AbdullahAlNafisah/fpga-acoustic-localization/docs/figures/after LPF.PNG

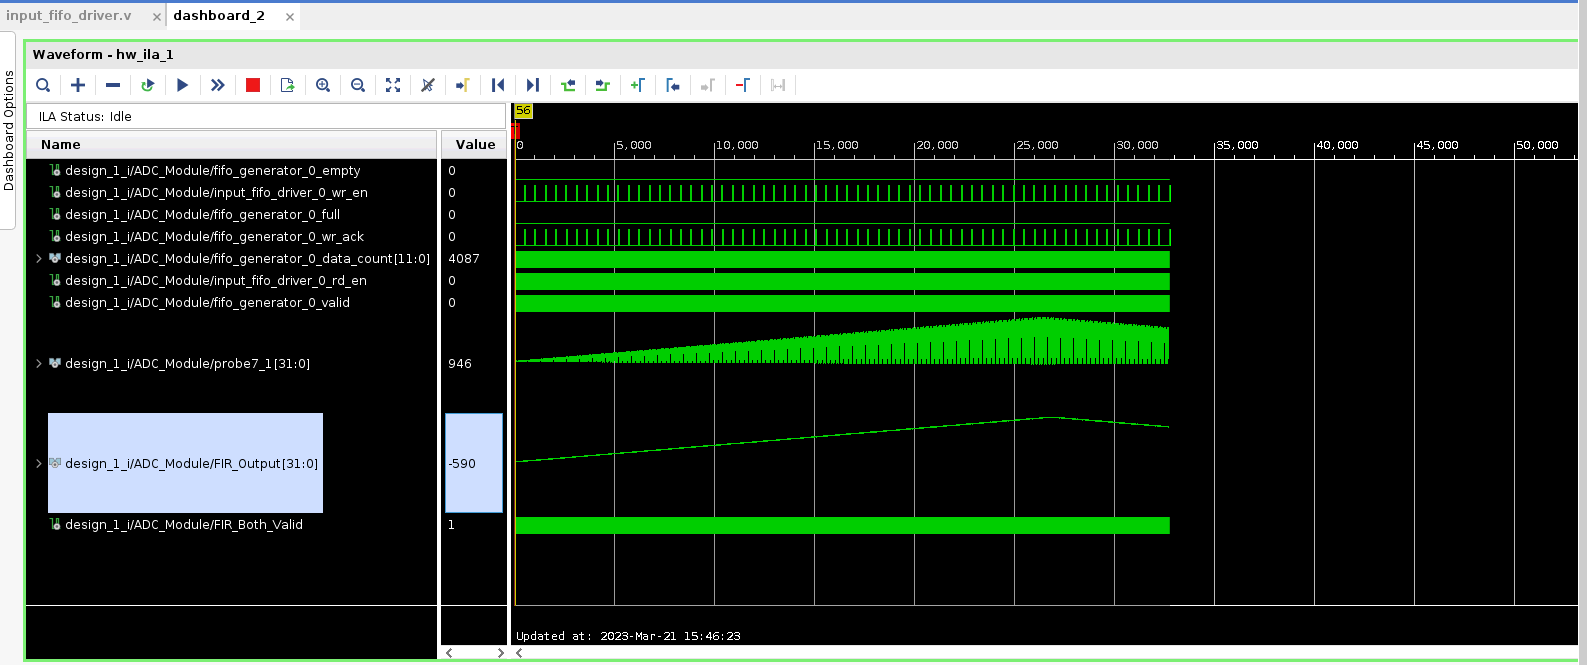
docs/figures/after LPF.PNG
