AbdullahAlNafisah/fpga-acoustic-localization/docs/figures/avgDist.png

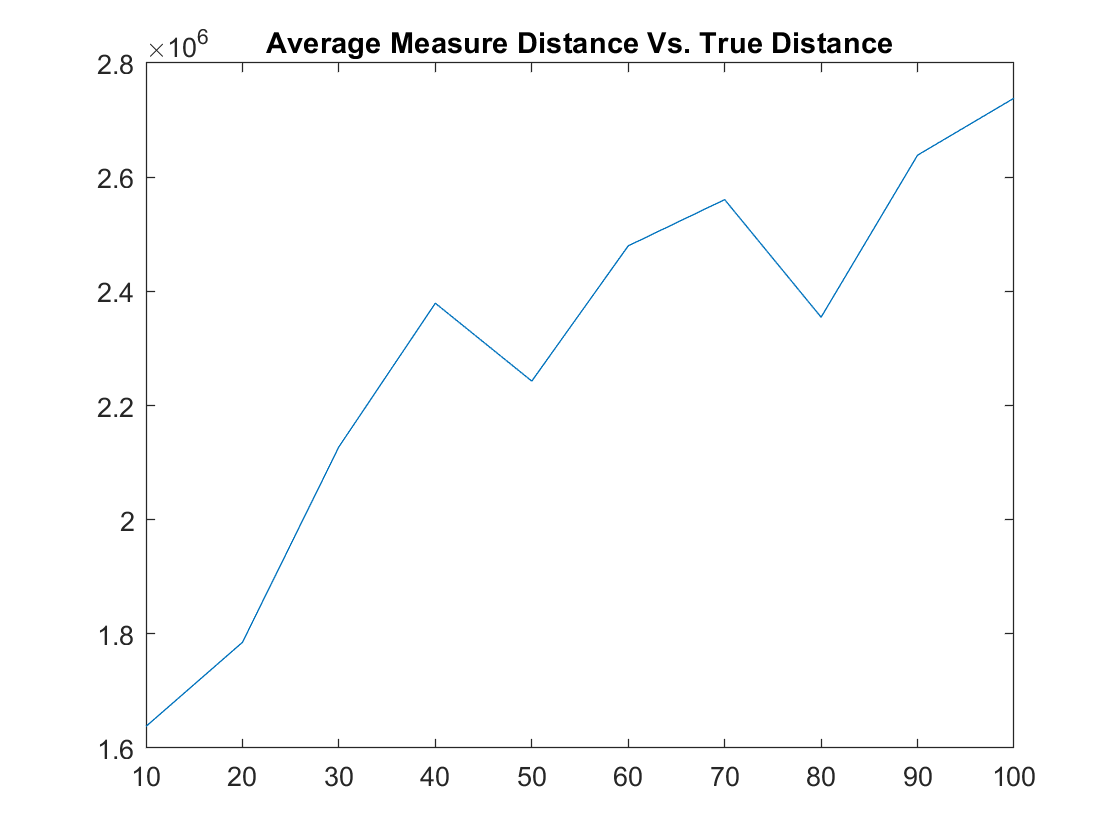
docs/figures/avgDist.png
