AbdullahAlNafisah/fpga-acoustic-localization/docs/figures/clock_drift_lin.jpg

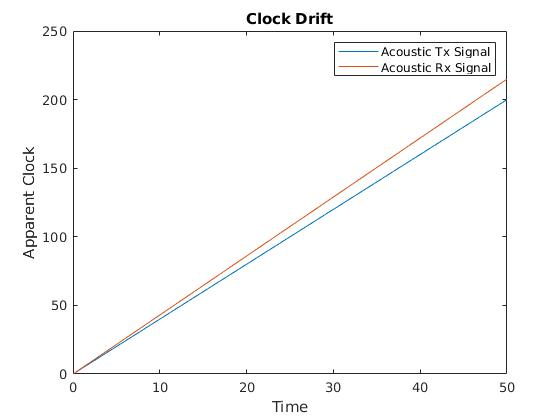
docs/figures/clock_drift_lin.jpg
