AbdullahAlNafisah/fpga-acoustic-localization/docs/figures/clock_drift_saw.jpg

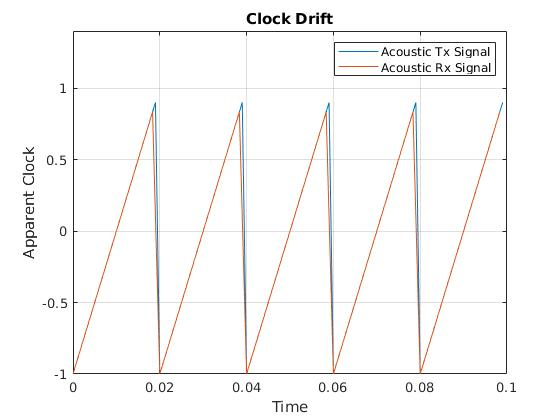
docs/figures/clock_drift_saw.jpg
