AbdullahAlNafisah/fpga-acoustic-localization/docs/figures/realAfterMult.png

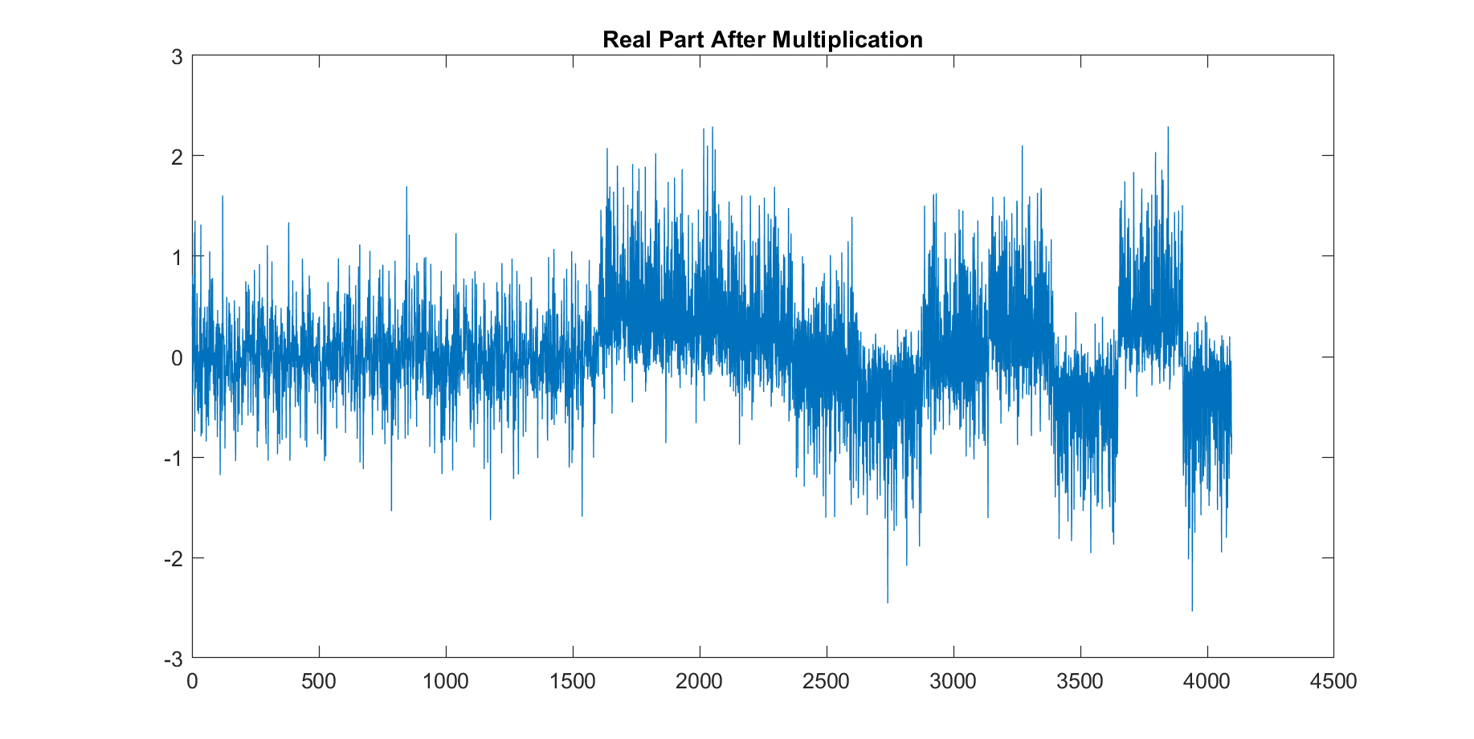
docs/figures/realAfterMult.png
