AbdullahAlNafisah/fpga-acoustic-localization/matlab/fpga_sim/Std.png

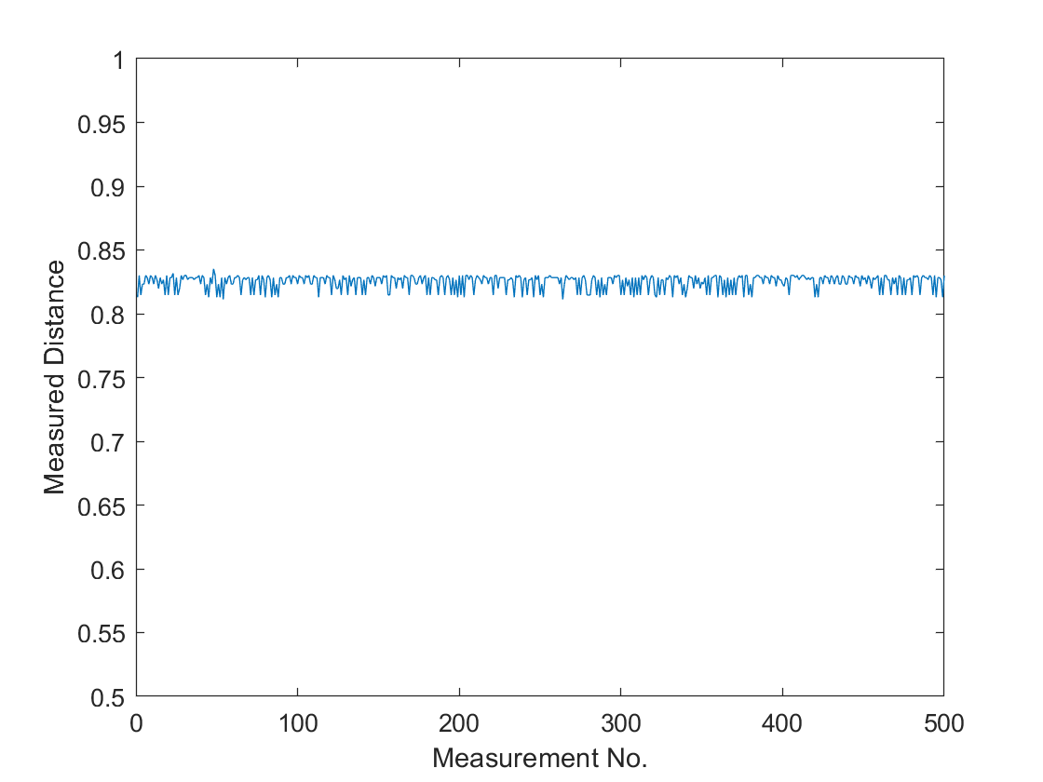
matlab/fpga_sim/Std.png
