AbdullahAlNafisah/fpga-acoustic-localization/matlab/fpga_sim/stds_all.png

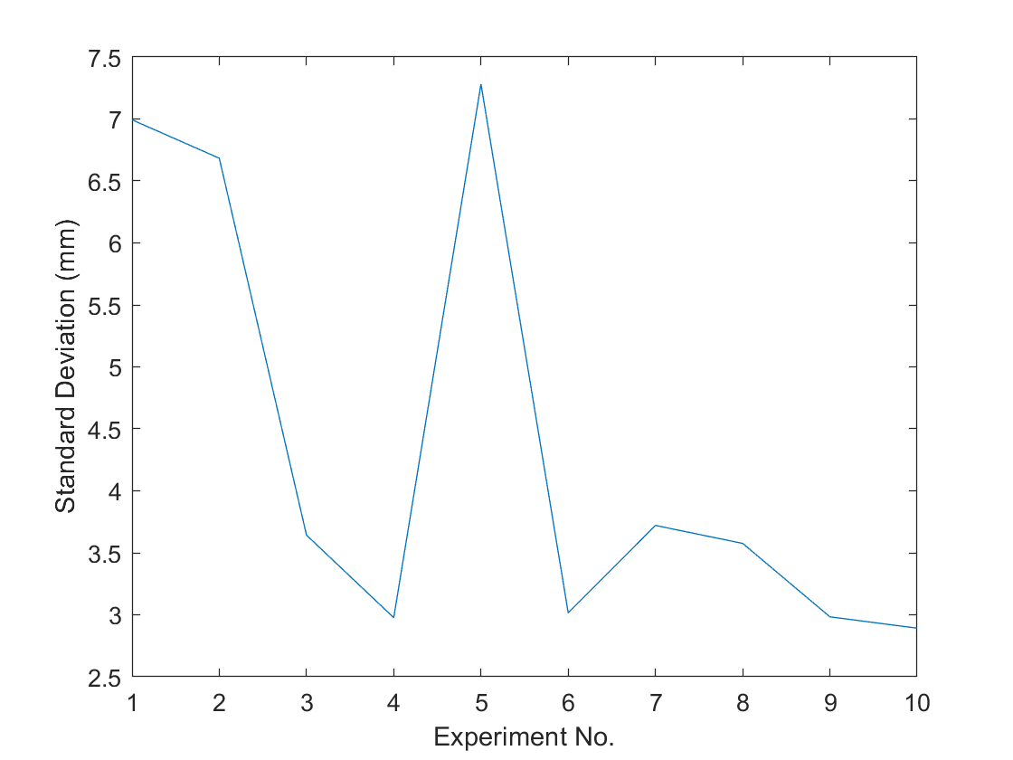
matlab/fpga_sim/stds_all.png
