AbdullahAlNafisah/fpga-acoustic-localization/matlab/fpga_sim/Delay Index Measurement.png

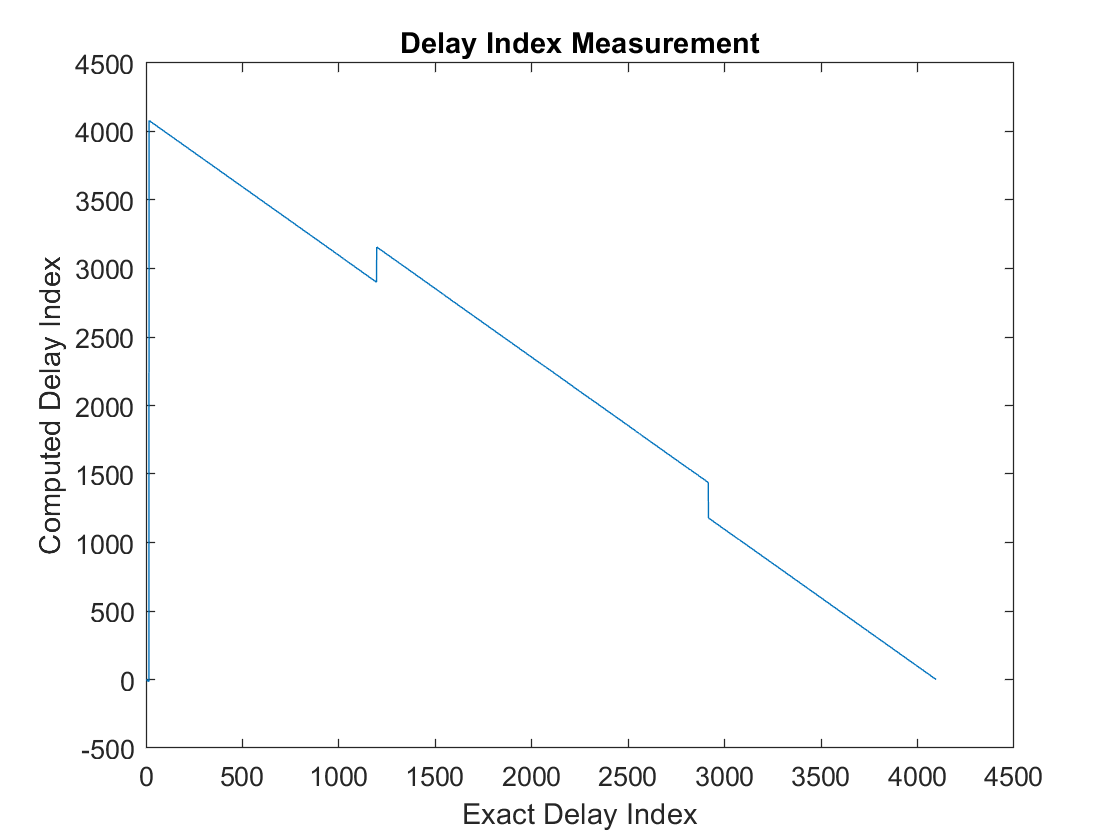
matlab/fpga_sim/Delay Index Measurement.png
