AbdullahAlNafisah/fpga-acoustic-localization/matlab/fpga_sim/Delay Index Measurement_v2.png

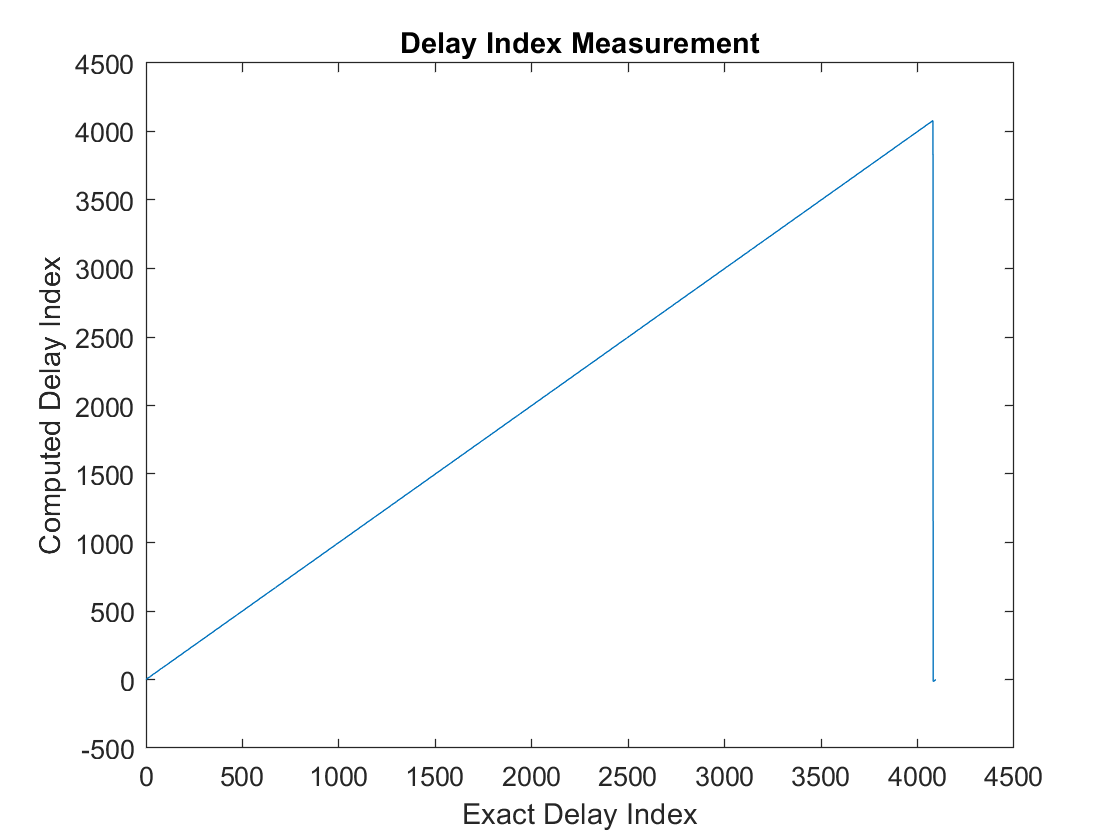
matlab/fpga_sim/Delay Index Measurement_v2.png
