AbdullahAlNafisah/fpga-acoustic-localization/hw/zc_tx/project_1/project_1.srcs/sources_1/new/zc_sound.v

`timescale 1ns / 1ps
module zc_sound #(
    parameter amp_bits = 12,
    parameter sample_depth = 12)(
    input clk,
    input [sample_depth-1:0] index,
    output reg [amp_bits-1:0] pwm_dc
    );
    (* rom_style = "block"*)
    reg [sample_depth-1:0] reg_index;
    always@(posedge clk) begin
        reg_index <= index;
    end
always@(*) begin
case (reg_index)
0 : pwm_dc <= 'b111111111111;
1 : pwm_dc <= 'b111001111000;
2 : pwm_dc <= 'b101001111000;
3 : pwm_dc <= 'b010110000111;
4 : pwm_dc <= 'b000110000111;
5 : pwm_dc <= 'b000000000000;
6 : pwm_dc <= 'b000110000111;
7 : pwm_dc <= 'b010110000111;
8 : pwm_dc <= 'b101001111000;
9 : pwm_dc <= 'b111001111000;
10 : pwm_dc <= 'b111111111111;
11 : pwm_dc <= 'b111001111000;
12 : pwm_dc <= 'b101001111000;
13 : pwm_dc <= 'b010110000111;
14 : pwm_dc <= 'b000110000111;
15 : pwm_dc <= 'b000000000000;
16 : pwm_dc <= 'b000110000111;
17 : pwm_dc <= 'b010110000111;
18 : pwm_dc <= 'b101001111000;
19 : pwm_dc <= 'b111001111000;
20 : pwm_dc <= 'b111111111111;
21 : pwm_dc <= 'b111001111000;
22 : pwm_dc <= 'b101001111000;
23 : pwm_dc <= 'b010110000111;
24 : pwm_dc <= 'b000110000111;
25 : pwm_dc <= 'b000000000000;
26 : pwm_dc <= 'b000110000111;
27 : pwm_dc <= 'b010110000111;
28 : pwm_dc <= 'b101001111000;
29 : pwm_dc <= 'b111001111000;
30 : pwm_dc <= 'b111111111111;
31 : pwm_dc <= 'b111001111000;
32 : pwm_dc <= 'b101001111000;
33 : pwm_dc <= 'b010110000111;
34 : pwm_dc <= 'b000110000111;
35 : pwm_dc <= 'b000000000000;
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
3650 : pwm_dc <= 'b001101111001;
3651 : pwm_dc <= 'b100000110111;
3652 : pwm_dc <= 'b110011100000;
3653 : pwm_dc <= 'b111110101011;
3654 : pwm_dc <= 'b111110001001;
3655 : pwm_dc <= 'b110010000110;
3656 : pwm_dc <= 'b011111001000;
3657 : pwm_dc <= 'b001100011111;
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
