AbdullahAlNafisah/fpga-acoustic-localization/hw/aco_rx_eth/ACO_RX/ACO_RX.srcs/sources_1/new/crc_gen.v

`timescale 1ps / 1ps

//////////////////////////////////////////////////////////////////////////////////
// Company: HdlForBeginners
// Engineer:
//
// Create Date: 13.11.2021 13:55:40
// Design Name:
// Module Name: crc_gen
// Project Name:
// Target Devices:
// Tool Versions:
// Description:
//
// Dependencies:
//
// Revision:
// Revision 0.01 - File Created
// Additional Comments:
//
//////////////////////////////////////////////////////////////////////////////////

module crc_gen
  (
   input [1:0]   data_in,
   input         crc_en,
   output [31:0] crc_out,
   input         rst,
   input         clk);

   wire [31:0]  lfsr_c;
   reg [31:0]  lfsr_q;

   // xor on the output
   assign crc_out = lfsr_c ^ 32'hffffffff;

   // used https://bues.ch/cms/hacking/crcgen to generate this code

   // -------------------------------------------------------------------------
   // THIS IS GENERATED VERILOG CODE.
   // https://bues.ch/h/crcgen
   //
   // This code is Public Domain.
   // Permission to use, copy, modify, and/or distribute this software for any
   // purpose with or without fee is hereby granted.
   //
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
   // CRC polynomial coefficients: x^32 + x^26 + x^23 + x^22 + x^16 + x^12 + x^11 + x^10 + x^8 + x^7 + x^5 + x^4 + x^2 + x + 1
   //                              0xEDB88320 (hex)
   // CRC width:                   32 bits
   // CRC shift direction:         right (little endian)
   // Input word width:            2 bits

   assign lfsr_c[0] = lfsr_q[2];
   assign lfsr_c[1] = lfsr_q[3];
   assign lfsr_c[2] = lfsr_q[4];
   assign lfsr_c[3] = lfsr_q[5];
   assign lfsr_c[4] = (data_in[0] ^ lfsr_q[0] ^ lfsr_q[6]);
   assign lfsr_c[5] = (data_in[1] ^ lfsr_q[1] ^ lfsr_q[7]);
   assign lfsr_c[6] = lfsr_q[8];
   assign lfsr_c[7] = (data_in[0] ^ lfsr_q[0] ^ lfsr_q[9]);
   assign lfsr_c[8] = (data_in[0] ^ data_in[1] ^ lfsr_q[0] ^ lfsr_q[1] ^ lfsr_q[10]);
   assign lfsr_c[9] = (data_in[1] ^ lfsr_q[1] ^ lfsr_q[11]);
   assign lfsr_c[10] = lfsr_q[12];
   assign lfsr_c[11] = lfsr_q[13];
   assign lfsr_c[12] = lfsr_q[14];
   assign lfsr_c[13] = lfsr_q[15];
   assign lfsr_c[14] = (data_in[0] ^ lfsr_q[0] ^ lfsr_q[16]);
   assign lfsr_c[15] = (data_in[1] ^ lfsr_q[1] ^ lfsr_q[17]);
   assign lfsr_c[16] = lfsr_q[18];
   assign lfsr_c[17] = lfsr_q[19];
   assign lfsr_c[18] = (data_in[0] ^ lfsr_q[0] ^ lfsr_q[20]);
   assign lfsr_c[19] = (data_in[0] ^ data_in[1] ^ lfsr_q[0] ^ lfsr_q[1] ^ lfsr_q[21]);
   assign lfsr_c[20] = (data_in[0] ^ data_in[1] ^ lfsr_q[0] ^ lfsr_q[1] ^ lfsr_q[22]);
   assign lfsr_c[21] = (data_in[1] ^ lfsr_q[1] ^ lfsr_q[23]);
   assign lfsr_c[22] = (data_in[0] ^ lfsr_q[0] ^ lfsr_q[24]);
   assign lfsr_c[23] = (data_in[0] ^ data_in[1] ^ lfsr_q[0] ^ lfsr_q[1] ^ lfsr_q[25]);
   assign lfsr_c[24] = (data_in[1] ^ lfsr_q[1] ^ lfsr_q[26]);
   assign lfsr_c[25] = (data_in[0] ^ lfsr_q[0] ^ lfsr_q[27]);
   assign lfsr_c[26] = (data_in[0] ^ data_in[1] ^ lfsr_q[0] ^ lfsr_q[1] ^ lfsr_q[28]);
   assign lfsr_c[27] = (data_in[1] ^ lfsr_q[1] ^ lfsr_q[29]);
   assign lfsr_c[28] = (data_in[0] ^ lfsr_q[0] ^ lfsr_q[30]);
   assign lfsr_c[29] = (data_in[0] ^ data_in[1] ^ lfsr_q[0] ^ lfsr_q[1] ^ lfsr_q[31]);
   assign lfsr_c[30] = (data_in[0] ^ data_in[1] ^ lfsr_q[0] ^ lfsr_q[1]);
   assign lfsr_c[31] = (data_in[1] ^ lfsr_q[1]);

   // -------------------------------------------------------------------------

  always @(posedge clk, posedge rst) begin
    if(rst) begin
      lfsr_q <= {32{1'b1}};
    end
    else begin
      lfsr_q <= crc_en ? lfsr_c : lfsr_q;
    end
  end // always
endmodule // crc
