AbdullahAlNafisah/fpga-acoustic-localization/hw/fft_corr/FFT_to_IFFT/FFT_to_IFFT.srcs/sim_1/imports/new/DEMOD_TB.v

`timescale 1ns / 1ps
//////////////////////////////////////////////////////////////////////////////////
// Company:
// Engineer:
//
// Create Date: 02/17/2023 11:25:38 PM
// Design Name:
// Module Name: DEMOD_TB
// Project Name:
// Target Devices:
// Tool Versions:
// Description:
//
// Dependencies:
//
// Revision:
// Revision 0.01 - File Created
// Additional Comments:
//
//////////////////////////////////////////////////////////////////////////////////


module DEMOD_TB ();


    reg         clk             = 1'd0;
    reg         rst_n           = 1'd0;
    wire [11:0] mod_data              ;
    reg         mod_data_tvalid = 1'd0;
    wire        mod_data_tready       ;
    wire [32:0] sqrd_out              ;
    wire        sqrd_out_tvalid       ;
    wire        sqrd_out_tlast        ;


    reg [11:0] mod_data_ram[4095:0];

    reg [11:0] mod_data_count = 12'd0;

    DEMOD_FFT_MULT i_DEMOD_FFT_MULT (
        .clk            (clk            ),
        .rst_n          (rst_n          ),
        .mod_data       (mod_data       ),
        .mod_data_tvalid(mod_data_tvalid),
        .mod_data_tready(mod_data_tready),
        .sqrd_out       (sqrd_out       ),
        .sqrd_out_tvalid(sqrd_out_tvalid),
        .sqrd_out_tlast (sqrd_out_tlast )
    );
//////////////////////////////////////////////////////////////////////////////////
    assign mod_data = mod_data_ram[mod_data_count];
//////////////////////////////////////////////////////////////////////////////////
    initial begin
        clk            <= 1'd0 ;
        rst_n          <= 1'd0 ;
        // mod_data       <= 12'd0;
        mod_data_tvalid <= 1'd0 ;
        #50;
        rst_n          <= 1'd1 ;
        #50;
        #50;
        mod_data_tvalid <= 1'd1 ;
        #41000;
        $finish;
    end
//////////////////////////////////////////////////////////////////////////////////
    always begin
        #5 clk<=~clk;
    end
//////////////////////////////////////////////////////////////////////////////////
    always @(posedge clk or negedge rst_n) begin : proc_mod_data_count
        if(~rst_n) begin
            mod_data_count <= 0;
        end else if(mod_data_tvalid == 'b1) begin
            mod_data_count <= mod_data_count + 1'b1;
        end else begin
            mod_data_count <= mod_data_count;
        end
    end
//////////////////////////////////////////////////////////////////////////////////
    initial begin
        mod_data_ram[0]=12'hFFF;
        mod_data_ram[1]=12'hE78;
        mod_data_ram[2]=12'hA78;
        mod_data_ram[3]=12'h587;
        mod_data_ram[4]=12'h187;
        mod_data_ram[5]=12'h000;
        mod_data_ram[6]=12'h187;
        mod_data_ram[7]=12'h587;
        mod_data_ram[8]=12'hA78;
        mod_data_ram[9]=12'hE78;
        mod_data_ram[10]=12'hFFF;
        mod_data_ram[11]=12'hE78;
        mod_data_ram[12]=12'hA78;
        mod_data_ram[13]=12'h587;
        mod_data_ram[14]=12'h187;
        mod_data_ram[15]=12'h000;
        mod_data_ram[16]=12'h187;
        mod_data_ram[17]=12'h587;
        mod_data_ram[18]=12'hA78;
        mod_data_ram[19]=12'hE78;
        mod_data_ram[20]=12'hFFF;
        mod_data_ram[21]=12'hE78;
        mod_data_ram[22]=12'hA78;
        mod_data_ram[23]=12'h587;
        mod_data_ram[24]=12'h187;
        mod_data_ram[25]=12'h000;
        mod_data_ram[26]=12'h187;
        mod_data_ram[27]=12'h587;
        mod_data_ram[28]=12'hA78;
        mod_data_ram[29]=12'hE78;
        mod_data_ram[30]=12'hFFF;
        mod_data_ram[31]=12'hE78;
        mod_data_ram[32]=12'hA78;
        mod_data_ram[33]=12'h587;
        mod_data_ram[34]=12'h187;
        mod_data_ram[35]=12'h000;
        mod_data_ram[36]=12'h187;
        mod_data_ram[37]=12'h587;
        mod_data_ram[38]=12'hA78;
        mod_data_ram[39]=12'hE78;
        mod_data_ram[40]=12'hFFF;
        mod_data_ram[41]=12'hE78;
        mod_data_ram[42]=12'hA78;
        mod_data_ram[43]=12'h587;
        mod_data_ram[44]=12'h187;
        mod_data_ram[45]=12'h000;
        mod_data_ram[46]=12'h187;
        mod_data_ram[47]=12'h587;
        mod_data_ram[48]=12'hA78;
        mod_data_ram[49]=12'hE78;
        mod_data_ram[50]=12'hFF9;
        mod_data_ram[51]=12'hED0;
        mod_data_ram[52]=12'hB0D;
        mod_data_ram[53]=12'h620;
        mod_data_ram[54]=12'h1E9;
        mod_data_ram[55]=12'h006;
        mod_data_ram[56]=12'h12F;
        mod_data_ram[57]=12'h4F2;
        mod_data_ram[58]=12'h9DF;
        mod_data_ram[59]=12'hE16;
        mod_data_ram[60]=12'hFF9;
        mod_data_ram[61]=12'hED0;
        mod_data_ram[62]=12'hB0D;
        mod_data_ram[63]=12'h620;
        mod_data_ram[64]=12'h1E9;
        mod_data_ram[65]=12'h006;
        mod_data_ram[66]=12'h12F;
        mod_data_ram[67]=12'h4F2;
        mod_data_ram[68]=12'h9DF;
        mod_data_ram[69]=12'hE16;
        mod_data_ram[70]=12'hFF9;
        mod_data_ram[71]=12'hED0;
        mod_data_ram[72]=12'hB0D;
        mod_data_ram[73]=12'h620;
        mod_data_ram[74]=12'h1E9;
        mod_data_ram[75]=12'h006;
        mod_data_ram[76]=12'h12F;
        mod_data_ram[77]=12'h4F2;
        mod_data_ram[78]=12'h9DF;
        mod_data_ram[79]=12'hE16;
        mod_data_ram[80]=12'hFF9;
        mod_data_ram[81]=12'hED0;
        mod_data_ram[82]=12'hB0D;
        mod_data_ram[83]=12'h620;
        mod_data_ram[84]=12'h1E9;
        mod_data_ram[85]=12'h006;
        mod_data_ram[86]=12'h12F;
        mod_data_ram[87]=12'h4F2;
        mod_data_ram[88]=12'h9DF;
        mod_data_ram[89]=12'hE16;
        mod_data_ram[90]=12'hFF9;
        mod_data_ram[91]=12'hED0;
        mod_data_ram[92]=12'hB0D;
        mod_data_ram[93]=12'h620;
        mod_data_ram[94]=12'h1E9;
        mod_data_ram[95]=12'h006;
        mod_data_ram[96]=12'h12F;
        mod_data_ram[97]=12'h4F2;
        mod_data_ram[98]=12'h9DF;
        mod_data_ram[99]=12'hE16;
        mod_data_ram[100]=12'hFC8;
        mod_data_ram[101]=12'hF61;
        mod_data_ram[102]=12'hC28;
        mod_data_ram[103]=12'h759;
        mod_data_ram[104]=12'h2C9;
        mod_data_ram[105]=12'h037;
        mod_data_ram[106]=12'h09E;
        mod_data_ram[107]=12'h3D7;
        mod_data_ram[108]=12'h8A6;
        mod_data_ram[109]=12'hD36;
        mod_data_ram[110]=12'hFC8;
        mod_data_ram[111]=12'hF61;
        mod_data_ram[112]=12'hC28;
        mod_data_ram[113]=12'h759;
        mod_data_ram[114]=12'h2C9;
        mod_data_ram[115]=12'h037;
        mod_data_ram[116]=12'h09E;
        mod_data_ram[117]=12'h3D7;
        mod_data_ram[118]=12'h8A6;
        mod_data_ram[119]=12'hD36;
        mod_data_ram[120]=12'hFC8;
        mod_data_ram[121]=12'hF61;
        mod_data_ram[122]=12'hC28;
        mod_data_ram[123]=12'h759;
        mod_data_ram[124]=12'h2C9;
        mod_data_ram[125]=12'h037;
        mod_data_ram[126]=12'h09E;
        mod_data_ram[127]=12'h3D7;
        mod_data_ram[128]=12'h8A6;
        mod_data_ram[129]=12'hD36;
        mod_data_ram[130]=12'hFC8;
        mod_data_ram[131]=12'hF61;
        mod_data_ram[132]=12'hC28;
        mod_data_ram[133]=12'h759;
        mod_data_ram[134]=12'h2C9;
        mod_data_ram[135]=12'h037;
        mod_data_ram[136]=12'h09E;
        mod_data_ram[137]=12'h3D7;
        mod_data_ram[138]=12'h8A6;
        mod_data_ram[139]=12'hD36;
        mod_data_ram[140]=12'hFC8;
        mod_data_ram[141]=12'hF61;
        mod_data_ram[142]=12'hC28;
        mod_data_ram[143]=12'h759;
        mod_data_ram[144]=12'h2C9;
        mod_data_ram[145]=12'h037;
        mod_data_ram[146]=12'h09E;
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
        mod_data_ram[3272]=12'h66D;
        mod_data_ram[3273]=12'hB56;
        mod_data_ram[3274]=12'hEF8;
        mod_data_ram[3275]=12'hFF1;
        mod_data_ram[3276]=12'hDE1;
        mod_data_ram[3277]=12'h992;
        mod_data_ram[3278]=12'h4A9;
        mod_data_ram[3279]=12'h107;
        mod_data_ram[3280]=12'h00E;
        mod_data_ram[3281]=12'h21E;
        mod_data_ram[3282]=12'h66D;
        mod_data_ram[3283]=12'hB56;
        mod_data_ram[3284]=12'hEF8;
        mod_data_ram[3285]=12'hFF1;
        mod_data_ram[3286]=12'hDE1;
        mod_data_ram[3287]=12'h992;
        mod_data_ram[3288]=12'h4A9;
        mod_data_ram[3289]=12'h107;
        mod_data_ram[3290]=12'h00E;
        mod_data_ram[3291]=12'h21E;
        mod_data_ram[3292]=12'h66D;
        mod_data_ram[3293]=12'hB56;
        mod_data_ram[3294]=12'hEF8;
        mod_data_ram[3295]=12'hFF1;
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
