AbdullahAlNafisah/fpga-acoustic-localization/(commit log)

2022-08-31 spi master for nrf24
2022-09-01 nrf spi driver
2022-09-05 pwm sine tone
    [sin.xlsx]
2022-09-08 master + rx on one board
2022-09-09 master board design
2022-09-10 sync error runs
    [Run1_AC_Rx.csv, Run1_AC_Tx.csv, Run1_Master.csv]
2023-03-01 ila captures
    [ila_zc_fifo.csv, iladata.csv, iladata2.csv, iladata_unsignedDec.csv, mem_data.csv]
2023-03-14 filter design
2023-03-26 bench measurements 0-100 cm
2023-04-07 wired nrf + wired signal runs
2023-04-07 wireless runs
2023-05-12 fixed-point filter check
2023-05-22 uart distance readout
